jmpinit/babel-hardware/Anchor7/3d-models/Anchor7 Assembly v29.step

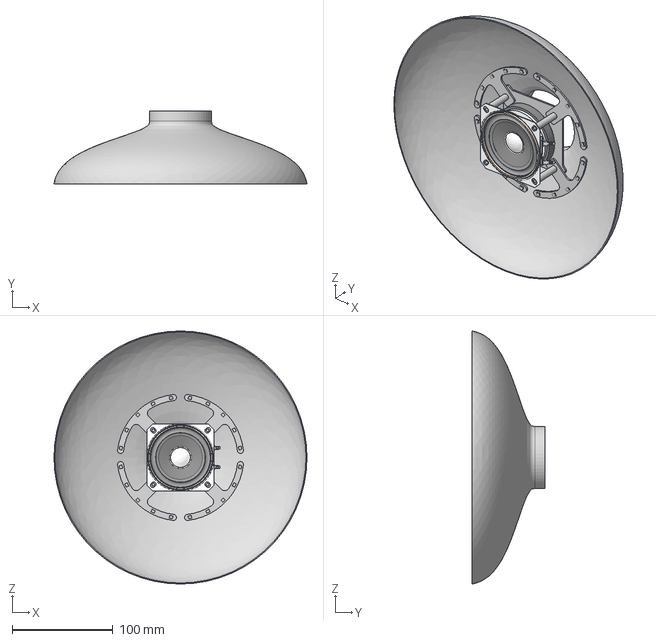
[picture p1: CAD file, 2023-08-23]
Anchor7/3d-models/Anchor7 Assembly v29.step
251.6 x 72.9 x 251.6 mm
AS06608PS-WR-R_1
Anchor Shade
