jmpinit/babel-hardware/Anchor7/3d-models/LSRNJ12555GL330MMY.step

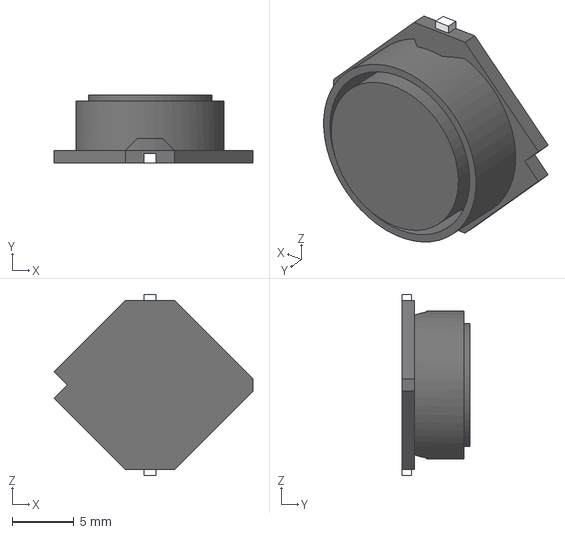
[picture p2: CAD file, 2023-08-23]
Anchor7/3d-models/LSRNJ12555GL330MMY.step
16.1 x 5.50 x 14.7 mm
