jmpinit/babel-hardware/Anchor7/3d/LSRNJ12555GL330MMY v2.obj

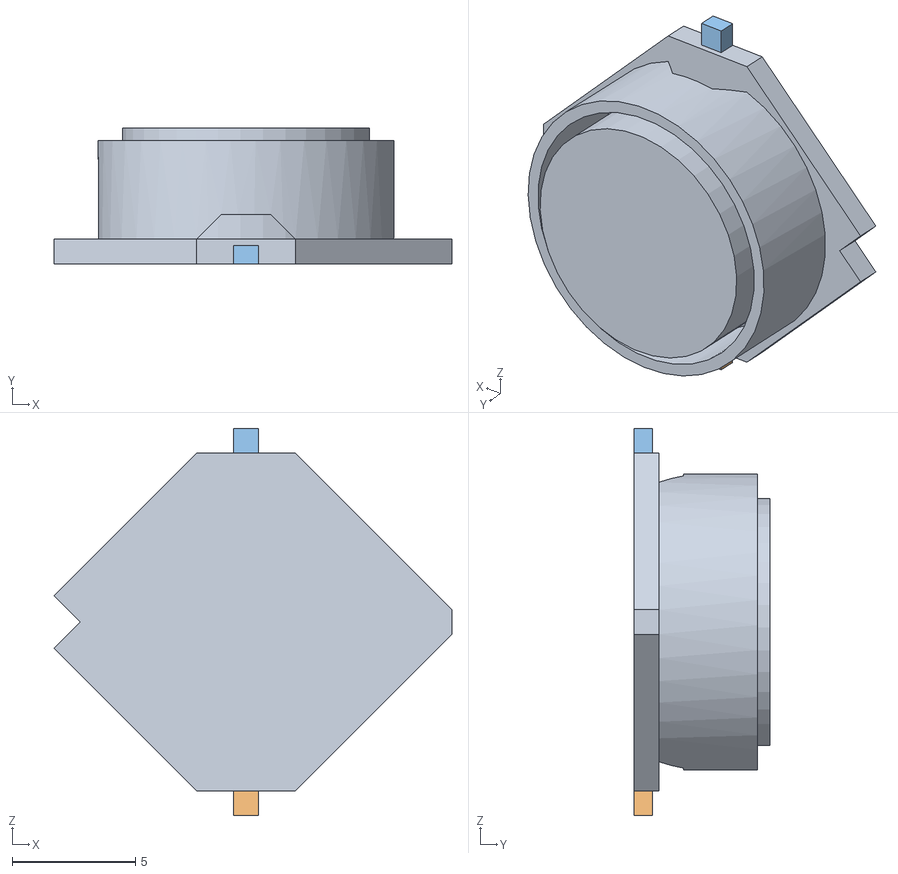
[picture p3: CAD file, 2023-08-23]
Anchor7/3d/LSRNJ12555GL330MMY v2.obj
16.1 x 5.50 x 15.7
Plastic
Pins
