jmpinit/babel-hardware/Anchor7/mechanical/anchor7_outline.dxf

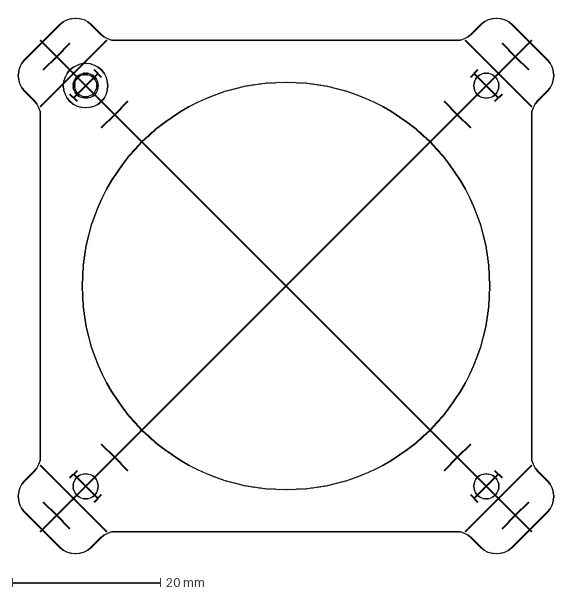
[picture p4: CAD file, 2023-08-23]
Anchor7/mechanical/anchor7_outline.dxf
72.9 x 72.9 mm
