jmpinit/babel-hardware/Anchor7_LEDs/3d-models/JK2835B LED v1.step

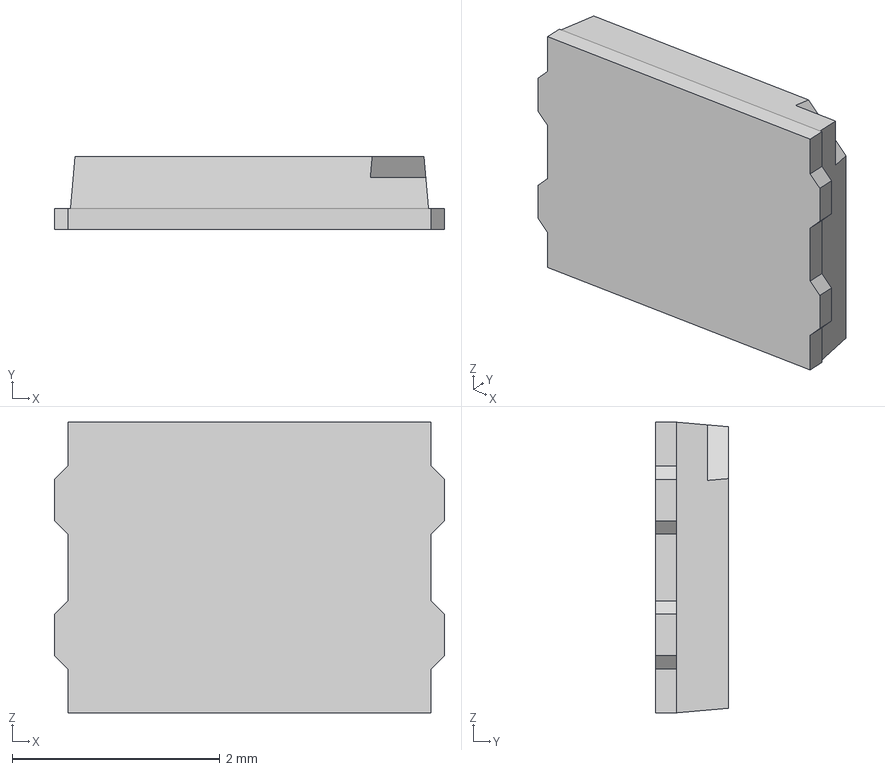
[picture p5: CAD file, 2023-08-23]
Anchor7_LEDs/3d-models/JK2835B LED v1.step
3.76 x 0.7 x 2.80 mm
