jmpinit/babel-hardware/Anchor7_LEDs/mechanical/anchor7_leds_outline.dxf

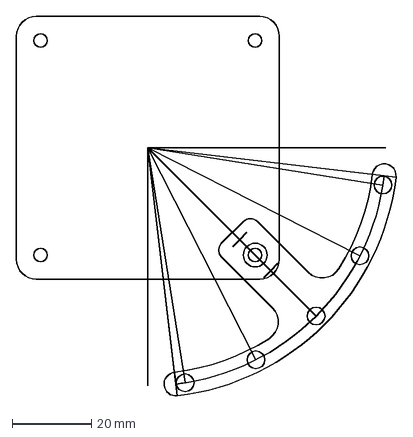
[picture p6: CAD file, 2023-08-23]
Anchor7_LEDs/mechanical/anchor7_leds_outline.dxf
95.8 x 95.9 mm
