jmpinit/babel-hardware/Anchor7/3d-models/0ZCF0075AF2C.STEP

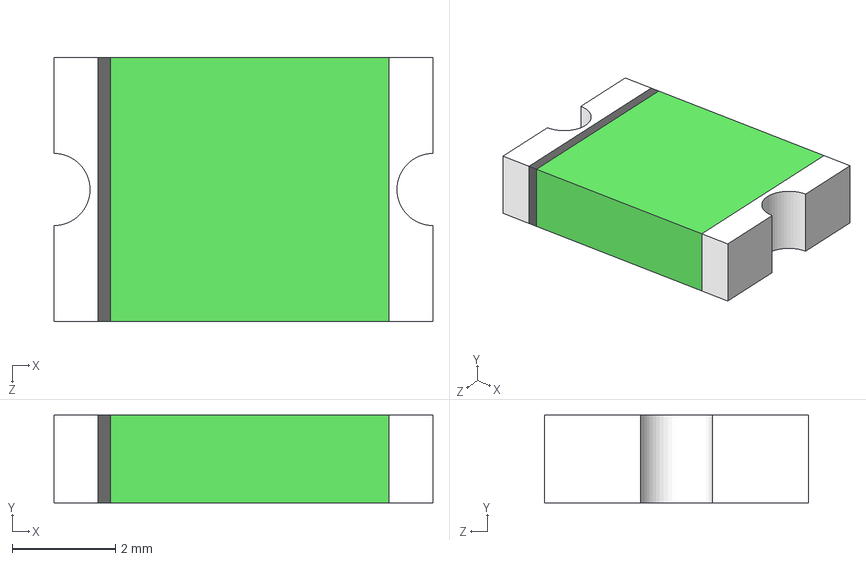
[picture p7: CAD file, 2023-08-23]
Anchor7/3d-models/0ZCF0075AF2C.STEP
7.36 x 1.70 x 5.12 mm
