jmpinit/babel-hardware/(list of files, cad)

Other CAD files:
Anchor7/3d/LSRNJ12555GL330MMY v1.obj
Anchor7/3d-models/LSRNJ12555GL330MMY.blend
