jmpinit/babel-hardware/Anchor7/Anchor7.pdf

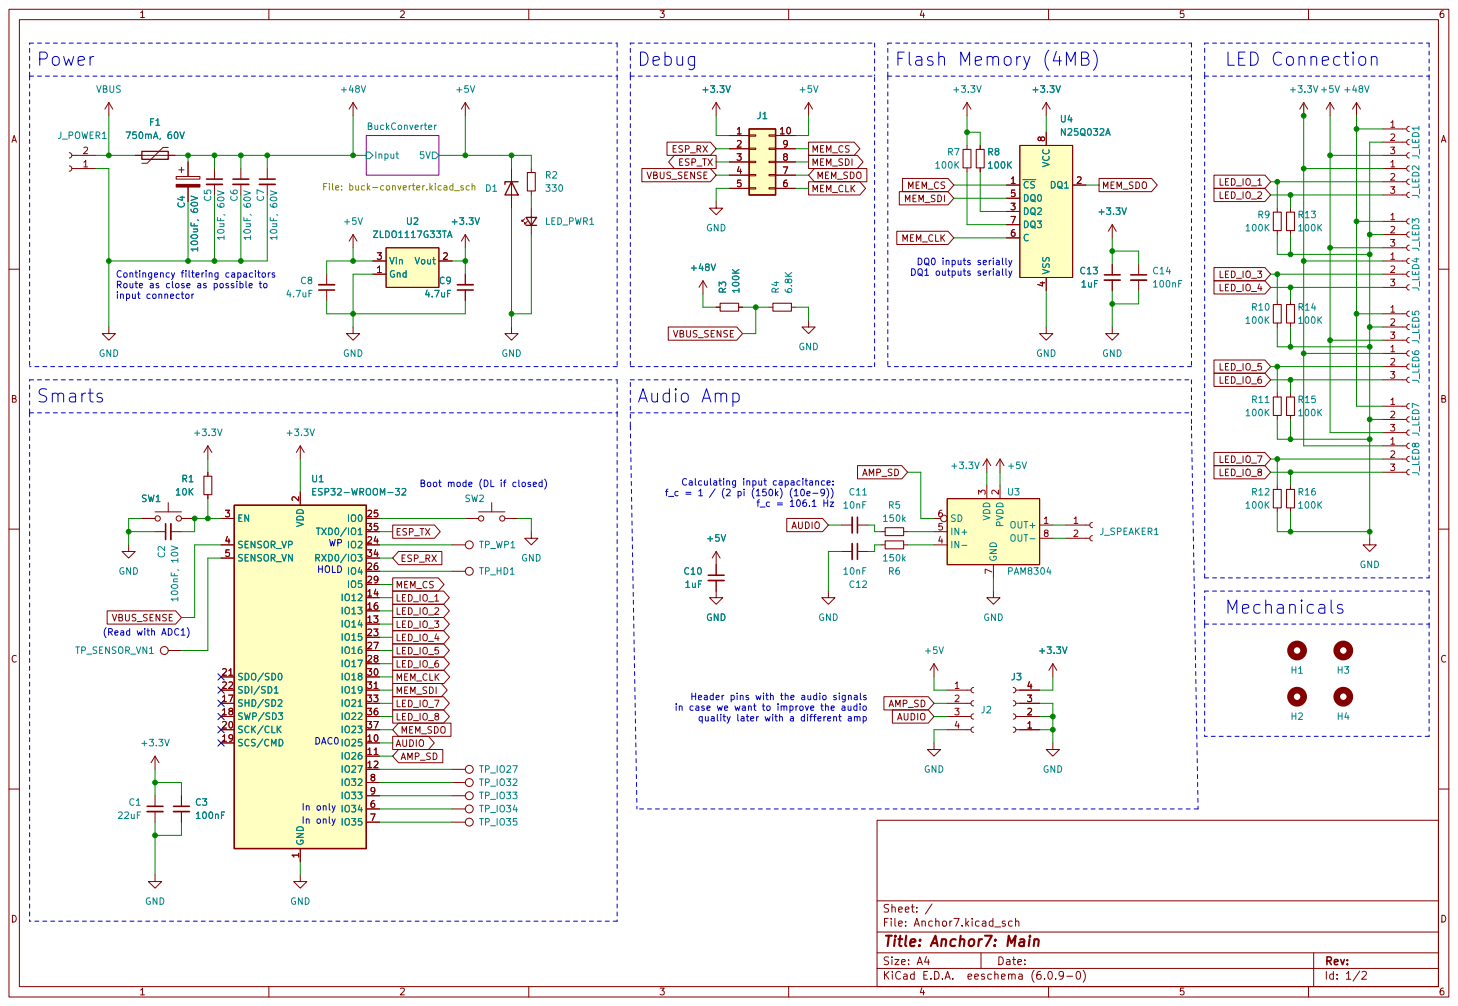
[picture p8: page 1]

Contingency filtering capacitors
Route as close as possible to
input connector
SW1 GND GND
Smarts

2 SCK/CLK 20 SDO/SD0 21 SDI/SD1 22

Header pins with the audio signals
in case we want to improve the audio
quality later with a different amp

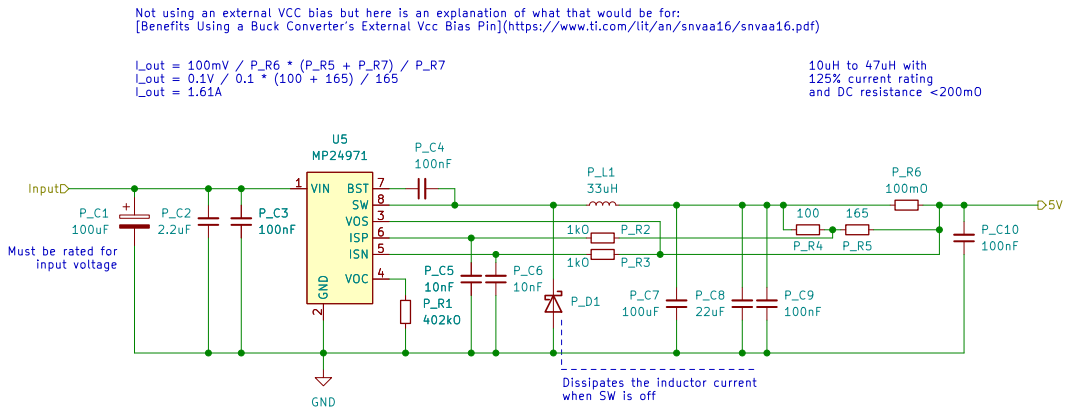
[picture p9: page 2]

I_out = 1.61A Not using an external VCC bias but here is an explanation of what that would be for:
[Benefits Using a Buck Converter's External Vcc Bias Pin](https://www.ti.com/lit/an/snvaa16/snvaa16.pdf)

Dissipates the inductor current when SW is off Must be rated for

File: buck-converter.kicad_sch Sheet: /BuckConverter/
Id: 2/2 Title: Anchor7: Buck Converter to 5V, 1.5A
