jmpinit/babel-hardware/Anchor7/Anchor7.kicad_pcb

## KiCad design Anchor7/Anchor7.kicad_pcb (2023-08-23)

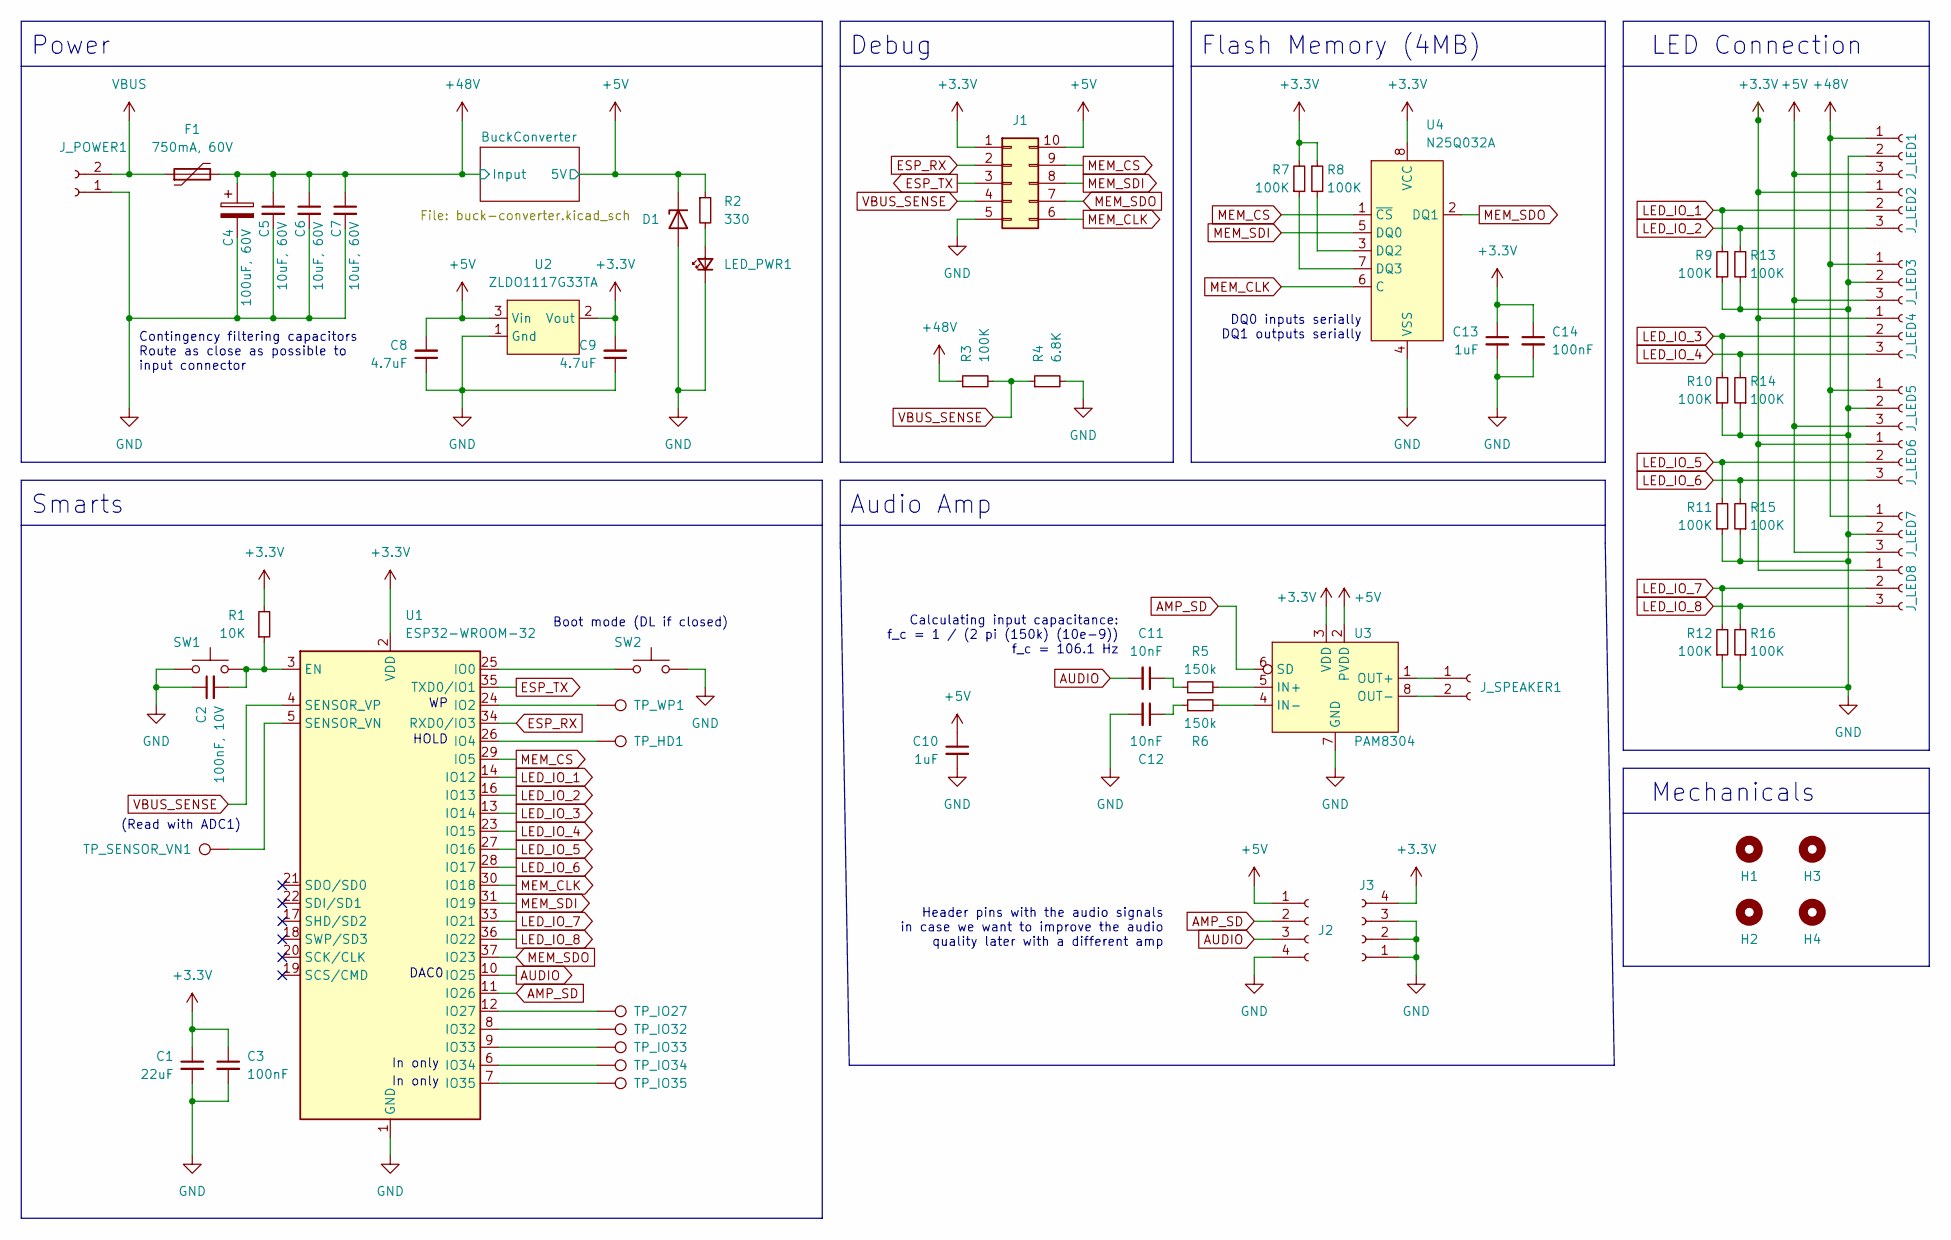
[picture p10: schematic Anchor7.kicad_sch, Anchor7: Main]

Parts:
C1: 22uF; C_0603_1608Metric; Digi-Key Part Number 1276-1274-2-ND
C2: 100nF, 10V; C_0402_1005Metric; Digi-Key Part Number 1276-1043-2-ND
C3, C14: 100nF; C_0402_1005Metric; Digi-Key Part Number 1276-1043-2-ND
C4: 100uF, 60V; CP_Radial_D8.0mm_P3.50mm
C5, C6, C7: 10uF, 60V; C_1206_3216Metric; Digi-Key Part Number 1276-7053-2-ND
C8, C9: 4.7uF; C_0603_1608Metric; Digi-Key Part Number 1276-1044-2-ND
C10, C13: 1uF; C_0603_1608Metric; Digi-Key Part Number 1276-1945-2-ND
C11, C12: 10nF; C_0402_1005Metric; Digi-Key Part Number 478-1114-2-ND
D1: 5.1V; SOT-23; Digi-Key Part Number 1727-2939-2-ND
F1: 750mA, 60V; Fuse_2920_7451Metric_Pad2.10x5.45mm_HandSolder; Digi-Key Part Number 507-1743-2-ND
H1, H2, H3, H4: MountingHole; MountingHole_3.2mm_M3
J1: Conn_02x05_Counter_Clockwise; Tag-Connect_TC2050-IDC-FP_2x05_P1.27mm_Vertical
J2, J3: Conn_01x04_Female; PinHeader_1x04_P2.54mm_Vertical
J_LED1, J_LED2, J_LED3, J_LED4, J_LED5, J_LED6, J_LED7, J_LED8: Conn_01x03_Female; PinHeader_1x03_P2.54mm_Vertical
J_POWER1: Conn_01x02_Female; Anchor_Power_2Pad
J_SPEAKER1: Conn_01x02_Female; PinHeader_1x02_P2.54mm_Vertical
LED_PWR1: LED_Small; LED_0402_1005Metric_Pad0.77x0.64mm_HandSolder
R1: 10K; R_0402_1005Metric; Digi-Key Part Number CR0402-JW-103GLFTR-ND
R2: 330; R_0402_1005Metric; Digi-Key Part Number 1292-WR04X331JTLTR-ND
R3, R7, R8, R9, R10, R11, R12, R13, R14, R15, R16: 100K; R_0402_1005Metric; Digi-Key Part Number 1292-WR04X104JTLTR-ND
R4: 6.8K; R_0402_1005Metric; Digi-Key Part Number 1292-WR04X682JTLTR-ND
R5, R6: 150k; R_0402_1005Metric; Digi-Key Part Number 1292-WR04X154JTLTR-ND
SW1, SW2: SW_Push; SW_SPST_PTS526; Digi-Key Part Number CKN12220-1-ND
TP_HD1: TestPoint; TestPoint_Pad_D1.5mm
TP_IO27, TP_IO32, TP_IO33, TP_IO34, TP_IO35: TestPoint; TestPoint_Pad_D1.5mm
TP_SENSOR_VN1: TestPoint; TestPoint_Pad_D1.5mm
TP_WP1: TestPoint; TestPoint_Pad_D1.5mm
U1: ESP32-WROOM-32
U2: ZLDO1117G33TA; SOT-223-3_TabPin2; Digi-Key Part Number ZLDO1117G33DITR-ND
U3: PAM8304; DFN-8-1EP_3x3mm_P0.65mm_EP1.55x2.4mm; Digi-Key Part Number PAM8304AYRDITR-ND
U4: N25Q032A; SOIC-8_3.9x4.9mm_P1.27mm; Digi-Key Part Number 1450-N25Q032A13ESC40FTR-ND

Connections:
+3V3: C1.1, C3.1, C9.2, C13.1, C14.1, J1.1, J3.4, J_LED2.1, J_LED4.1, J_LED6.1, J_LED8.1, R1.2, R7.2, R8.1, U1.2 (VDD), U2.2 (Vout), U3.3 (VDD), U4.8 (VCC)
+5V: C8.2, C10.1, D1.1 (K), J1.10, J2.1, J_LED1.3, J_LED3.3, J_LED5.3, J_LED7.3, R2.1, U2.3 (Vin), U3.2 (PVDD); also elsewhere on the board
+48V: C4.1, C5.1, C6.1, C7.1, F1.2, J_LED1.1, J_LED3.1, J_LED5.1, J_LED7.1, R3.1; also elsewhere on the board
AMP_SD: J2.2, U1.11 (IO26), U3.6 (SD)
AUDIO: C11.2, J2.3, U1.10 (IO25)
ESP_RX: J1.2, U1.34 (RXD0/IO3)
ESP_TX: J1.3, U1.35 (TXD0/IO1)
GND: C1.2, C2.1, C3.2, C4.2, C5.2, C6.2, C7.2, C8.1, C9.1, C10.2, C12.2, C13.2, C14.2, D1.2 (A), J1.5, J2.4, J3.1, J3.2, J3.3, J_LED1.2, J_LED3.2, J_LED5.2, J_LED7.2, J_POWER1.1, LED_PWR1.1 (K), R4.2, R9.1, R10.1, R11.1, R12.1, R13.1, R14.1, R15.1, R16.1, SW1.1, SW2.2, U1.1 (GND), U1.15 (GND), U1.38 (GND), U1.39 (GND), U2.1 (Gnd), U3.7 (GND), U4.4 (VSS); also elsewhere on the board
LED_IO_1: J_LED2.2, R9.2, U1.14 (IO12)
LED_IO_2: J_LED2.3, R13.2, U1.16 (IO13)
LED_IO_3: J_LED4.2, R10.2, U1.13 (IO14)
LED_IO_4: J_LED4.3, R14.2, U1.23 (IO15)
LED_IO_5: J_LED6.2, R11.2, U1.27 (IO16)
LED_IO_6: J_LED6.3, R15.2, U1.28 (IO17)
LED_IO_7: J_LED8.2, R12.2, U1.33 (IO21)
LED_IO_8: J_LED8.3, R16.2, U1.36 (IO22)
MEM_CLK: J1.6, U1.30 (IO18), U4.6 (C)
MEM_CS: J1.9, U1.29 (IO5), U4.1 (~CS)
MEM_SDI: J1.8, U1.31 (IO19), U4.5 (DQ0)
MEM_SDO: J1.7, U1.37 (IO23), U4.2 (DQ1)
unnamed: C2.2, R1.1, SW1.2, U1.3 (EN)
unnamed: C11.1, R5.1
unnamed: C12.1, R6.1
unnamed: J_SPEAKER1.1, U3.1 (OUT+)
unnamed: J_SPEAKER1.2, U3.8 (OUT-)
unnamed: LED_PWR1.2 (A), R2.2
unnamed: R5.2, U3.5 (IN+)
unnamed: R6.2, U3.4 (IN-)
unnamed: R7.1, U4.7 (DQ3)
unnamed: R8.2, U4.3 (DQ2)
unnamed: SW2.1, U1.25 (IO0)
unnamed: TP_HD1.1, U1.26 (IO4)
unnamed: TP_IO27.1, U1.12 (IO27)
unnamed: TP_IO32.1, U1.8 (IO32)
unnamed: TP_IO33.1, U1.9 (IO33)
unnamed: TP_IO34.1, U1.6 (IO34)
unnamed: TP_IO35.1, U1.7 (IO35)
unnamed: TP_SENSOR_VN1.1, U1.5 (SENSOR_VN)
unnamed: TP_WP1.1, U1.24 (IO2)
VBUS: F1.1, J_POWER1.2
VBUS_SENSE: J1.4, R3.2, R4.1, U1.4 (SENSOR_VP)

Notes on the sheet:
Header pins with the audio signals in case we want to improve the audio quality later with a different amp
Power
(Read with ADC1)
Smarts
Audio Amp
HOLD
Mechanicals
Contingency filtering capacitors Route as close as possible to input connector
In only
LED Connection
Flash Memory (4MB)
DAC0
Debug
DQ0 inputs serially DQ1 outputs serially
Boot mode (DL if closed)
Calculating input capacitance: f_c = 1 / (2 pi (150k) (10e-9)) f_c = 106.1 Hz

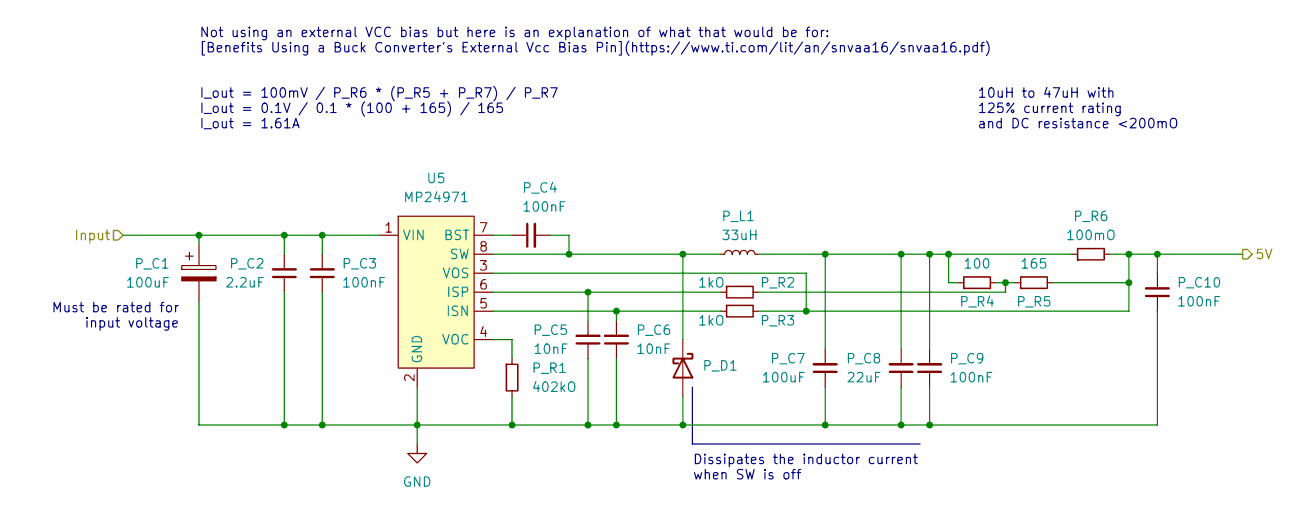
[picture p11: schematic buck-converter.kicad_sch, Anchor7: Buck Converter to 5V, 1.5A]

Parts:
P_C1: 100uF; CP_Radial_D8.0mm_P3.50mm; Digi-Key Part Number 1189-3041-ND
P_C2: 2.2uF; C_1206_3216Metric; Digi-Key Part Number 445-181654-2-ND
P_C3: 100nF; C_0805_2012Metric; Digi-Key Part Number 399-C0805C104KMREC7210TR-ND
P_C4, P_C9, P_C10: 100nF; C_0402_1005Metric; Digi-Key Part Number 1276-1004-2-ND
P_C5, P_C6: 10nF; C_0402_1005Metric; Digi-Key Part Number 478-04025C103MAT2ATR-ND
P_C7: 100uF; C_1210_3225Metric; Digi-Key Part Number 1276-1092-2-ND
P_C8: 22uF; C_0805_2012Metric; Digi-Key Part Number 490-10511-2-ND
P_D1: D_Schottky; D_SMA; Digi-Key Part Number 641-1102-2-ND
P_L1: 33uH; L_Taiyo-Yuden_NS-125xx; Digi-Key Part Number NS12555T330MN
P_R1: 402kO; R_0402_1005Metric; Digi-Key Part Number RMCF0402FT402KTR-ND
P_R2, P_R3: 1kO; R_0402_1005Metric; Digi-Key Part Number P1.0KJTR-ND
P_R4: 100; R_0402_1005Metric; Digi-Key Part Number CR0402-JW-101GLFTR-ND
P_R5: 165; R_0402_1005Metric; Digi-Key Part Number RMCF0402FT165RTR-ND
P_R6: 100mO; R_2512_6332Metric; Digi-Key Part Number CSRN2512FKR100TR-ND
U5: MP24971; SOIC-8-1EP_3.9x4.9mm_P1.27mm_EP2.29x3mm_ThermalVias; Digi-Key Part Number MP24971DN-LF-Z

Connections:
+5V: P_C10.2, P_R3.2, P_R5.2, P_R6.2, U5.3 (VOS); also elsewhere on the board
+48V: P_C1.1, P_C2.2, P_C3.2, U5.1 (VIN); also elsewhere on the board
GND: P_C1.2, P_C2.1, P_C3.1, P_C5.1, P_C6.1, P_C7.1, P_C8.1, P_C9.1, P_C10.1, P_D1.2 (A), P_R1.2, U5.2 (GND), U5.9 (GND); also elsewhere on the board
unnamed: P_C4.1, U5.7 (BST)
unnamed: P_C4.2, P_D1.1 (K), P_L1.1, U5.8 (SW)
unnamed: P_C5.2, P_R2.1, U5.6 (ISP)
unnamed: P_C6.2, P_R3.1, U5.5 (ISN)
unnamed: P_C7.2, P_C8.2, P_C9.2, P_L1.2, P_R4.1, P_R6.1
unnamed: P_R1.1, U5.4 (VOC)
unnamed: P_R2.2, P_R4.2, P_R5.1

Notes on the sheet:
10uH to 47uH with 125% current rating and DC resistance <200mO
Not using an external VCC bias but here is an explanation of what that would be for: [Benefits Using a Buck Converter's External Vcc Bias Pin](https://www.ti.com/lit/an/snvaa16/snvaa16.pdf)
Must be rated for input voltage
Dissipates the inductor current when SW is off
I_out = 100mV / P_R6 * (P_R5 + P_R7) / P_R7 I_out = 0.1V / 0.1 * (100 + 165) / 165 I_out = 1.61A

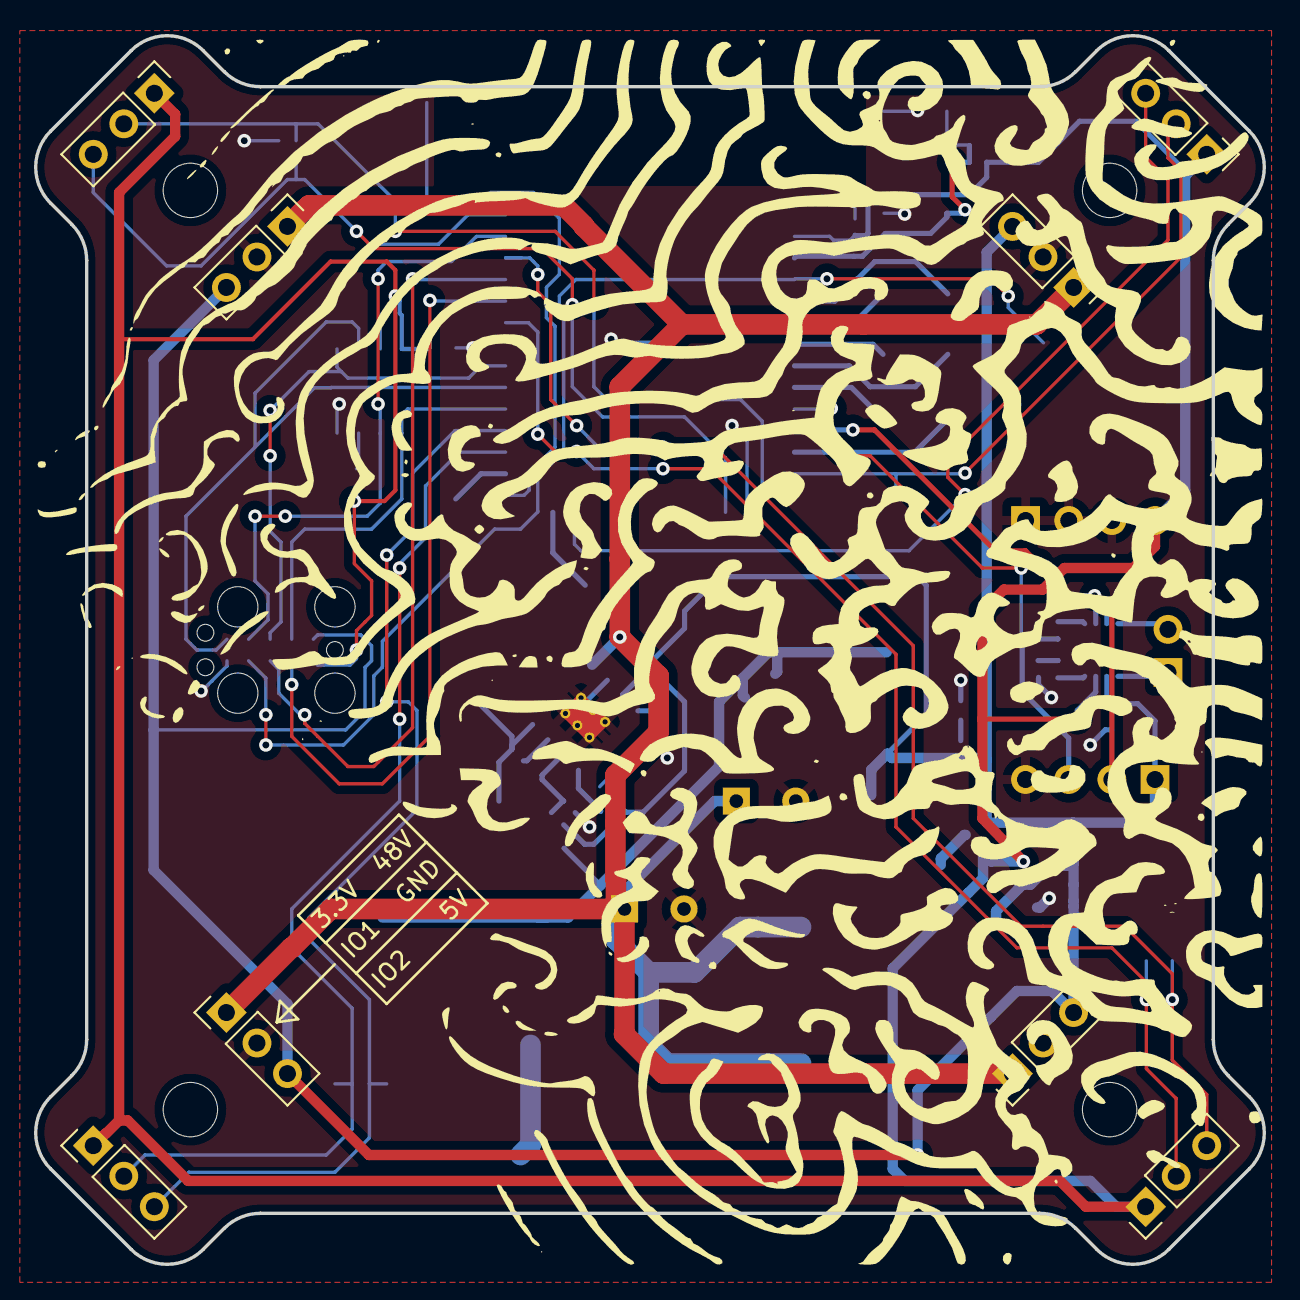
[picture p12: board Anchor7.kicad_pcb from above]

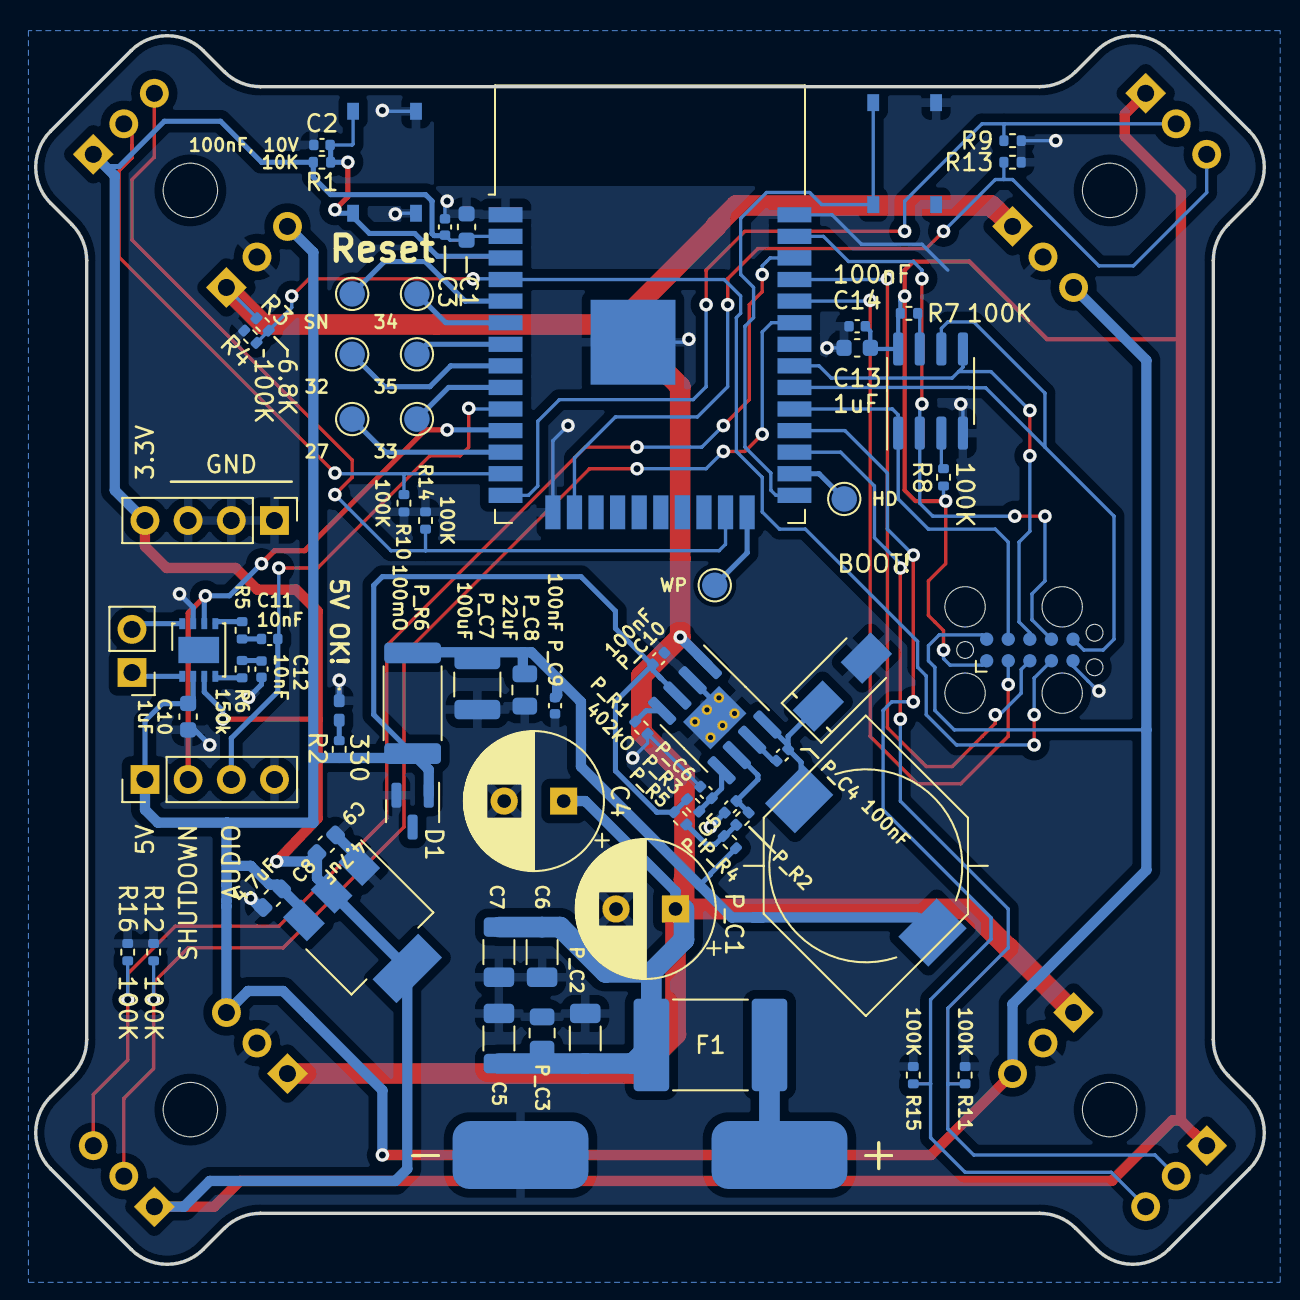
[picture p13: board Anchor7.kicad_pcb from below]

Board: 2 copper layers, 72.3 x 72.3 mm, 83 parts (75 on the bottom side), 48 nets.
