jmpinit/babel-hardware/Anchor7_LEDs/Anchor7_LEDs.kicad_pcb

## KiCad design Anchor7_LEDs/Anchor7_LEDs.kicad_pcb (2023-08-23)

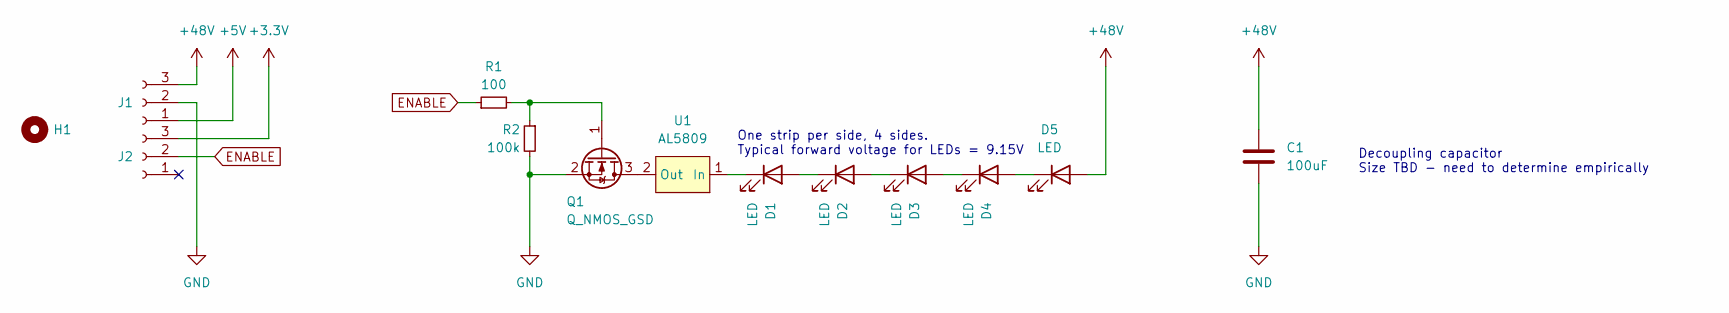
[picture p14: schematic Anchor7_LEDs.kicad_sch]

Parts:
C1: 100uF; C_0805_2012Metric
D1, D2, D3, D4, D5: LED; LED_PLCC_2835_Handsoldering; Digi-Key Part Number 2138-JK2835BWT-W-H40EC0000-N0000001TR-ND
H1: MountingHole; MountingHole_3.5mm
J1, J2: Conn_01x03_Female; PinHeader_1x03_P2.54mm_Vertical
Q1: Q_NMOS_GSD; SOT-723; Digi-Key Part Number NTK3134NT1G
R1: 100; R_0402_1005Metric
R2: 100k; R_0402_1005Metric
U1: AL5809; D_PowerDI-123; Digi-Key Part Number AL5809-100P1-7DITR-ND

Connections:
+3V3: J2.3
+5V: J1.1
+48V: C1.2, D5.2 (A), J1.3
ENABLE: J2.2, R1.1
GND: C1.1, J1.2, Q1.2 (S), R2.2
unnamed: D1.1 (K), U1.1 (In)
unnamed: D1.2 (A), D2.1 (K)
unnamed: D2.2 (A), D3.1 (K)
unnamed: D3.2 (A), D4.1 (K)
unnamed: D4.2 (A), D5.1 (K)
unnamed: Q1.1 (G), R1.2, R2.1
unnamed: Q1.3 (D), U1.2 (Out)

Notes on the sheet:
One strip per side, 4 sides. Typical forward voltage for LEDs = 9.15V
Decoupling capacitor Size TBD - need to determine empirically

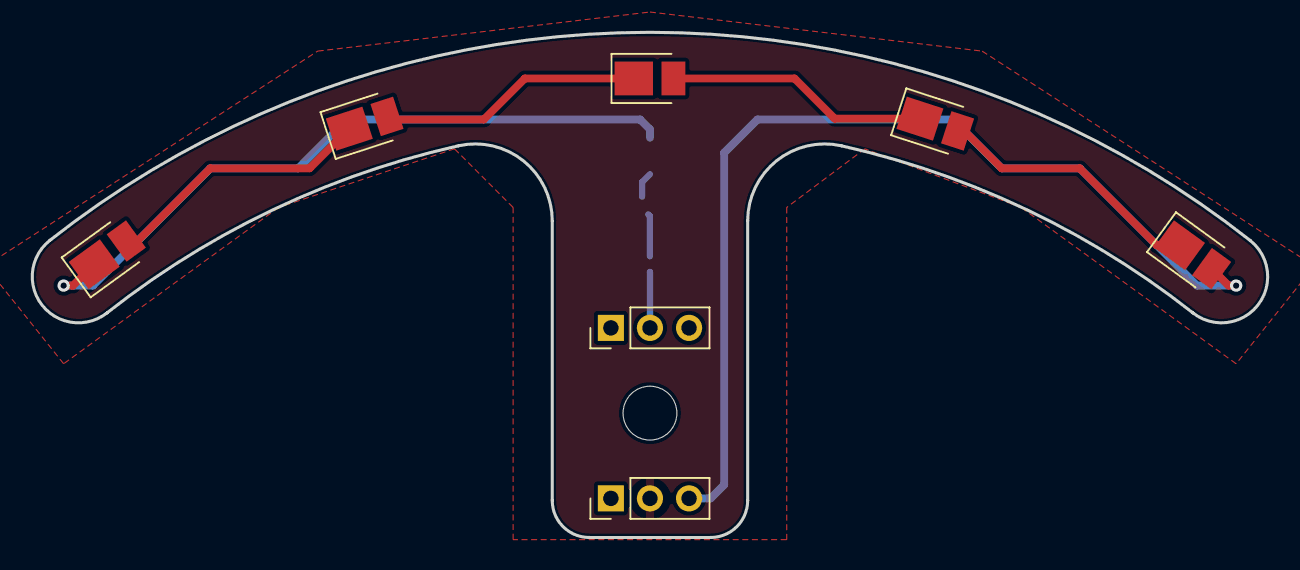
[picture p15: board Anchor7_LEDs.kicad_pcb from above]

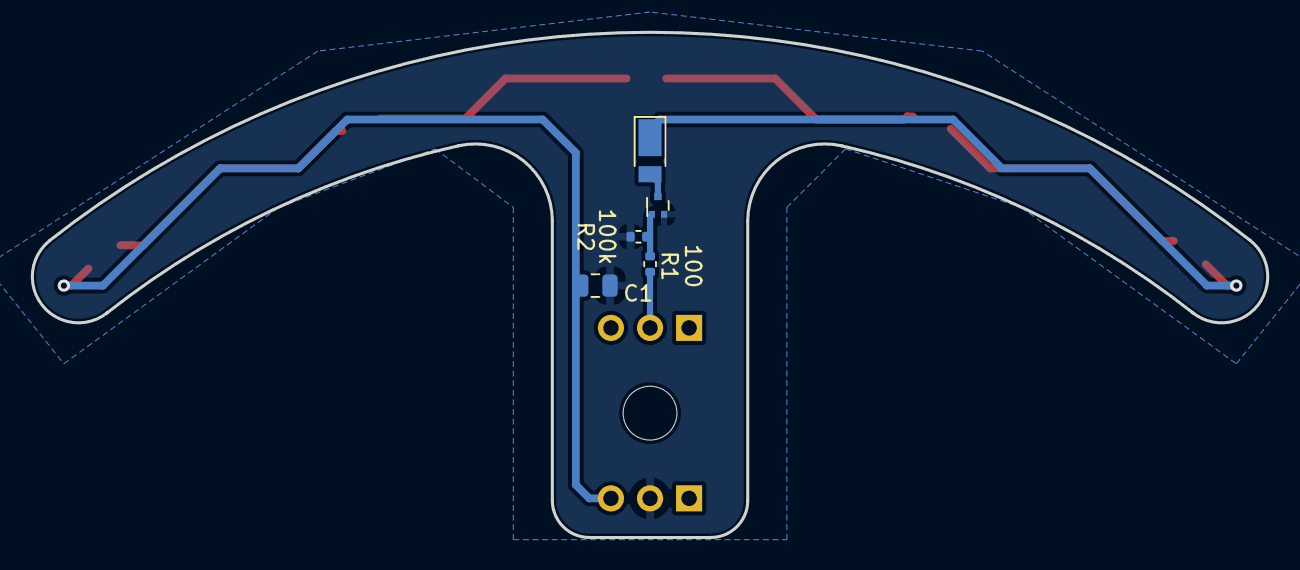
[picture p16: board Anchor7_LEDs.kicad_pcb from below]

Board: 2 copper layers, 80.3 x 32.8 mm, 13 parts (5 on the bottom side), 10 nets.
